MOSH-Insa-Toulouse/2019-ISS-A1-MOSH-BECHTET-MIHYUNKIM-HERAIL/notes.md

+ # Current

+ Shunt resistor: 10 Ohms
  + Normal Vshunt = 10mV
  + High Vshunt = 20mv
