MOSH-Insa-Toulouse/2019-ISS-A1-MOSH-BECHTET-MIHYUNKIM-HERAIL/CurrentMeasure/ALL0000/F0000CH1.CSV

Record Length | 2.500000e+03 | -1.250000000000 | 5.08000
Sample Interval | 1.000000e-03 | -1.249000000000 | 5.04000
Trigger Point | 1.250000000000e+03 | -1.248000000000 | 5.04000
 |  | -1.247000000000 | 5.08000
 |  | -1.246000000000 | 5.04000
 |  | -1.245000000000 | 5.04000
Source | CH1 | -1.244000000000 | 5.08000
Vertical Units | V | -1.243000000000 | 5.04000
Vertical Scale | 1.000000e+00 | -1.242000000000 | 5.08000
Vertical Offset | -6.960000e+00 | -1.241000000000 | 5.04000
Horizontal Units | s | -1.240000000000 | 5.08000
Horizontal Scale | 2.500000e-01 | -1.239000000000 | 5.04000
Pt Fmt | Y | -1.238000000000 | 5.08000
Yzero | 0.000000e+00 | -1.237000000000 | 5.04000
Probe Atten | 1.000000e+01 | -1.236000000000 | 5.08000
Model Number | TDS2001C | -1.235000000000 | 5.04000
Serial Number | C014408 | -1.234000000000 | 5.04000
Firmware Version | FV:v24.18 | -1.233000000000 | 5.08000
 |  | -01.232000000000 | 5.04000
 |  | -01.231000000000 | 5.04000
 |  | -01.230000000000 | 5.08000
 |  | -01.229000000000 | 5.04000
 |  | -01.228000000000 | 5.08000
 |  | -01.227000000000 | 5.04000
 |  | -01.226000000000 | 5.04000
 |  | -01.225000000000 | 5.04000
 |  | -01.224000000000 | 5.04000
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
