MOSH-Insa-Toulouse/2019-ISS-A1-MOSH-BECHTET-MIHYUNKIM-HERAIL/CurrentMeasure/ALL0000/F0000CH2.CSV

Record Length | 2.500000e+03 | -1.250000000000 | 4.12000
Sample Interval | 1.000000e-03 | -1.249000000000 | 4.12000
Trigger Point | 1.250000000000e+03 | -1.248000000000 | 4.12000
 |  | -1.247000000000 | 4.12000
 |  | -1.246000000000 | 4.12000
 |  | -1.245000000000 | 4.12000
Source | CH2 | -1.244000000000 | 4.16000
Vertical Units | V | -1.243000000000 | 4.12000
Vertical Scale | 1.000000e+00 | -1.242000000000 | 4.12000
Vertical Offset | -7.000000e+00 | -1.241000000000 | 4.12000
Horizontal Units | s | -1.240000000000 | 4.12000
Horizontal Scale | 2.500000e-01 | -1.239000000000 | 4.12000
Pt Fmt | Y | -1.238000000000 | 4.16000
Yzero | 0.000000e+00 | -1.237000000000 | 4.12000
Probe Atten | 1.000000e+01 | -1.236000000000 | 4.12000
Model Number | TDS2001C | -1.235000000000 | 4.08000
Serial Number | C014408 | -1.234000000000 | 4.08000
Firmware Version | FV:v24.18 | -1.233000000000 | 4.16000
 |  | -01.232000000000 | 4.16000
 |  | -01.231000000000 | 4.08000
 |  | -01.230000000000 | 4.16000
 |  | -01.229000000000 | 4.16000
 |  | -01.228000000000 | 4.12000
 |  | -01.227000000000 | 4.12000
 |  | -01.226000000000 | 4.12000
 |  | -01.225000000000 | 4.12000
 |  | -01.224000000000 | 4.12000
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
