MOSH-Insa-Toulouse/2019-ISS-A1-MOSH-BECHTET-MIHYUNKIM-HERAIL/CurrentMeasure/ALL0000/Vdiff1Kprep.csv

t | U | I
0 | 0.96 | 0.00096
0.001 | 0.92 | 0.00092
0.002 | 0.92 | 0.00092
0.003 | 0.96 | 0.00096
0.004 | 0.92 | 0.00092
0.005 | 0.92 | 0.00092
0.006 | 0.92 | 0.00092
0.007 | 0.92 | 0.00092
0.008 | 0.96 | 0.00096
0.009 | 0.92 | 0.00092
0.01 | 0.96 | 0.00096
0.011 | 0.92 | 0.00092
0.012 | 0.92 | 0.00092
0.013 | 0.92 | 0.00092
0.014 | 0.96 | 0.00096
0.015 | 0.96 | 0.00096
0.016 | 0.96 | 0.00096
0.017 | 0.92 | 0.00092
0.018 | 0.88 | 0.00088
0.019 | 0.96 | 0.00096
0.02 | 0.92 | 0.00092
0.021 | 0.88 | 0.00088
0.022 | 0.96 | 0.00096
0.023 | 0.92 | 0.00092
0.024 | 0.92 | 0.00092
0.025 | 0.92 | 0.00092
0.026 | 0.92 | 0.00092
0.027 | 0.96 | 0.00096
0.028 | 0.92 | 0.00092
0.029 | 0.92 | 0.00092
0.03 | 0.92 | 0.00092
0.031 | 0.96 | 0.00096
0.032 | 0.92 | 0.00092
0.033 | 0.96 | 0.00096
0.034 | 0.92 | 0.00092
0.035 | 0.96 | 0.00096
0.036 | 0.92 | 0.00092
0.037 | 0.92 | 0.00092
0.038 | 0.92 | 0.00092
0.039 | 0.92 | 0.00092
0.04 | 0.92 | 0.00092
0.041 | 0.96 | 0.00096
0.042 | 0.96 | 0.00096
0.043 | 0.92 | 0.00092
0.044 | 0.92 | 0.00092
0.045 | 0.96 | 0.00096
0.046 | 0.96 | 0.00096
0.047 | 0.92 | 0.00092
0.048 | 0.92 | 0.00092
0.049 | 0.96 | 0.00096
0.05 | 0.88 | 0.00088
0.051 | 0.92 | 0.00092
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
