MOSH-Insa-Toulouse/2019-ISS-A1-MOSH-BECHTET-MIHYUNKIM-HERAIL/CurrentMeasure/ALL0000/F0000TEK.BMP

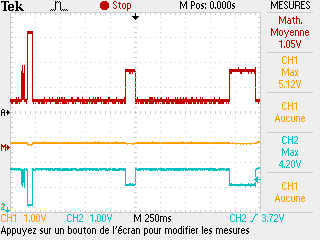
CurrentMeasure/ALL0000/F0000TEK.BMP
