MOSH-Insa-Toulouse/2019-ISS-A1-MOSH-BECHTET-MIHYUNKIM-HERAIL/GasSensor_Kicad/Communicating_GasSensor.kicad_pcb

## KiCad design GasSensor_Kicad/Communicating_GasSensor.kicad_pcb (2020-01-22)

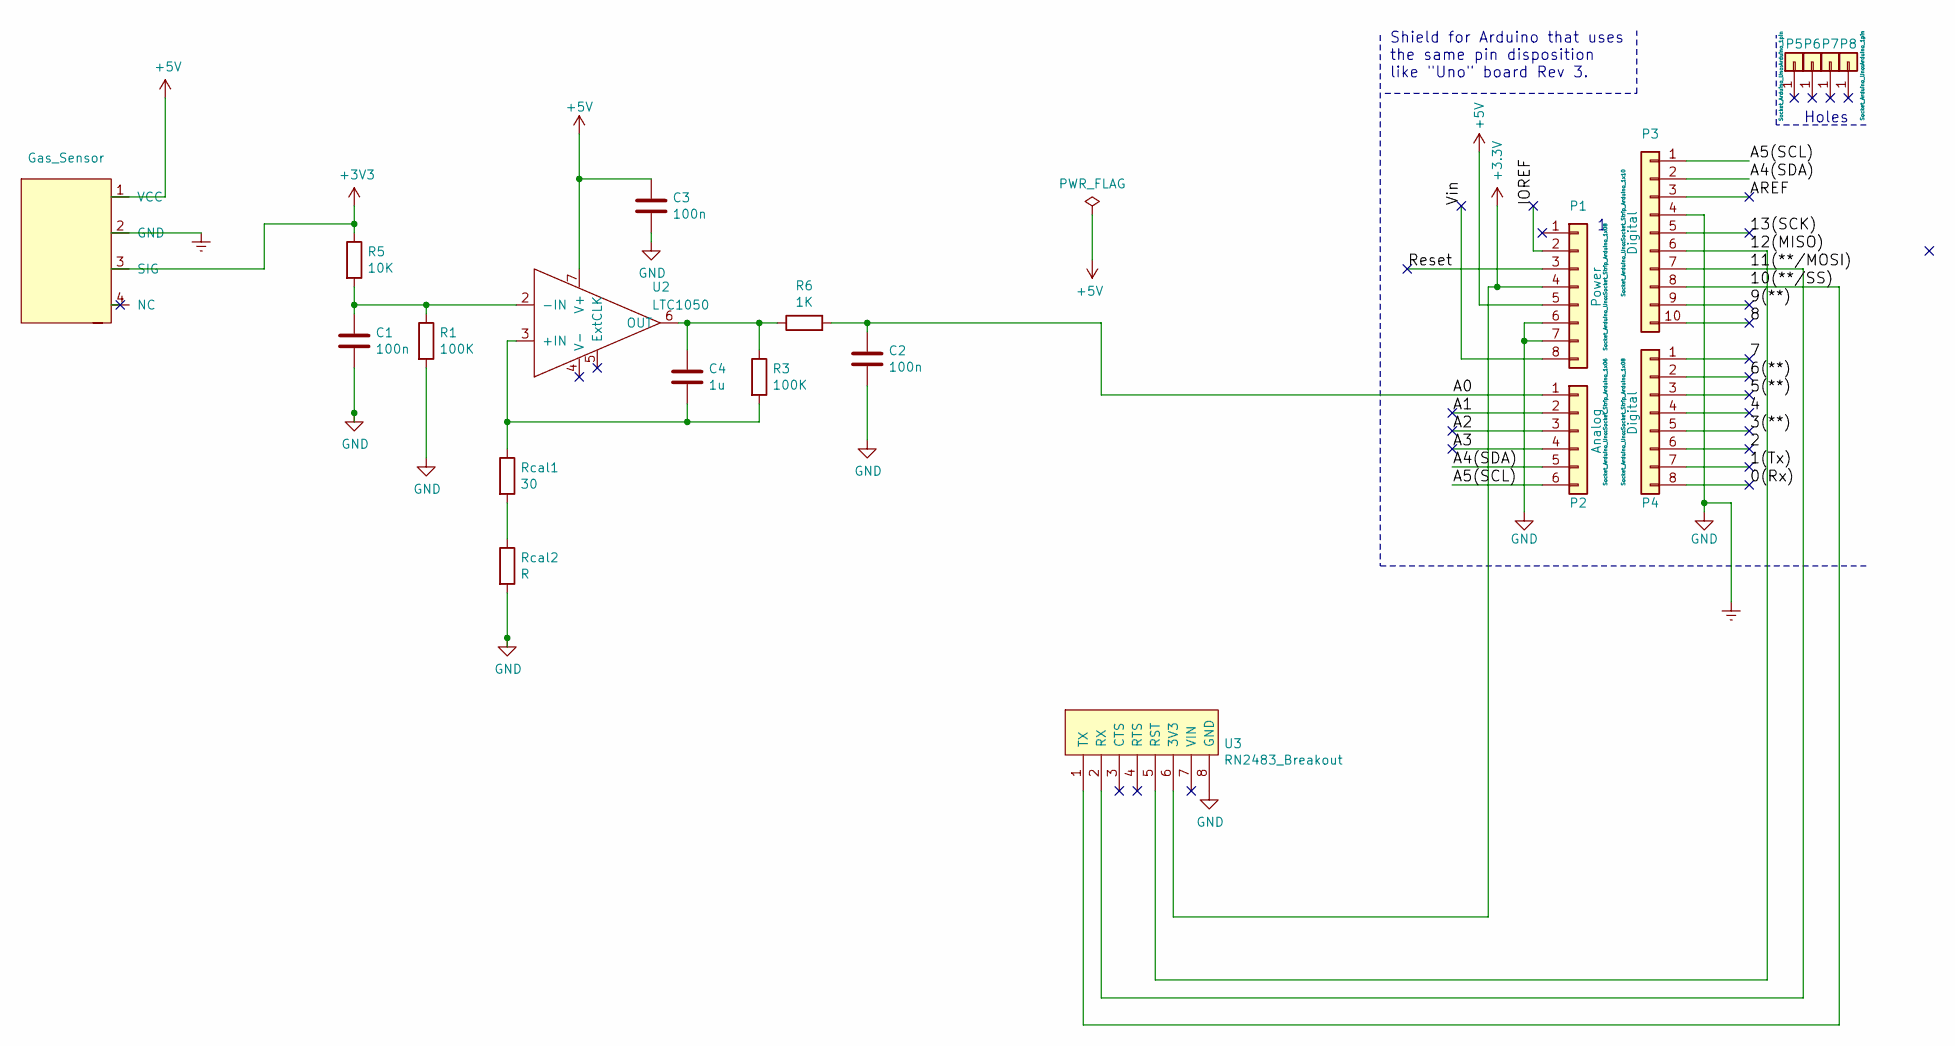
[picture p7: schematic Communicating_GasSensor.sch]

Parts:
C1, C2, C3: 100n; CP_Elec_4x3
C4: 1u; CP_Elec_4x3
P1: Power; Socket_Strip_Arduino_1x08
P2: Analog; Socket_Strip_Arduino_1x06
P3: Digital; Socket_Strip_Arduino_1x10
P4: Digital; Socket_Strip_Arduino_1x08
P5, P6, P7, P8: CONN_01X01; Arduino_1pin
R1, R3: 100K; R_Axial_DIN0204_L3.6mm_D1.6mm_P1.90mm_Vertical
R5: 10K; R_Axial_DIN0204_L3.6mm_D1.6mm_P1.90mm_Vertical
R6: 1K; R_Axial_DIN0204_L3.6mm_D1.6mm_P1.90mm_Vertical
Rcal1: 30; R_Axial_DIN0204_L3.6mm_D1.6mm_P1.90mm_Vertical
Rcal2: R; R_Axial_DIN0204_L3.6mm_D1.6mm_P1.90mm_Vertical
U1: Gas_Sensor; TO-5-4
U2: LTC1050; DIP-8_W7.62mm_LongPads
U3: RN2483_Breakout

Connections:
+5V: C3.1, P1.5, U1.1 (VCC), U2.7 (V+)
/0(Rx): P4.8
/1(Tx): P4.7
/2: P4.6
/3(**): P4.5
/4: P4.4
/5(**): P4.3
/6(**): P4.2
/7: P4.1
/8: P3.10
/9(**): P3.9
/10(**/SS): P3.8, U3.1 (TX)
/11(**/MOSI): P3.7, U3.2 (RX)
/12(MISO): P3.6, U3.5 (RST)
/13(SCK): P3.5
/A0: C2.1, P2.1, R6.2
/A1: P2.2
/A2: P2.3
/A3: P2.4
/A4(SDA): P2.5, P3.2
/A5(SCL): P2.6, P3.1
/AREF: P3.3
/IOREF: P1.2
/Reset: P1.3
/Vin: P1.8
Earth: C1.2, C2.2, C3.2, P1.6, P1.7, P3.4, R1.2, Rcal2.2, U1.2 (GND), U3.8 (GND)
unnamed: C1.1, R1.1, R5.2, U2.2 (-IN)
unnamed: C4.1, R3.1, R6.1, U2.6 (OUT)
unnamed: C4.2, R3.2, Rcal1.1, U2.3 (+IN)
unnamed: Rcal1.2, Rcal2.1

Notes on the sheet:
Holes
Shield for Arduino that uses the same pin disposition like "Uno" board Rev 3.

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
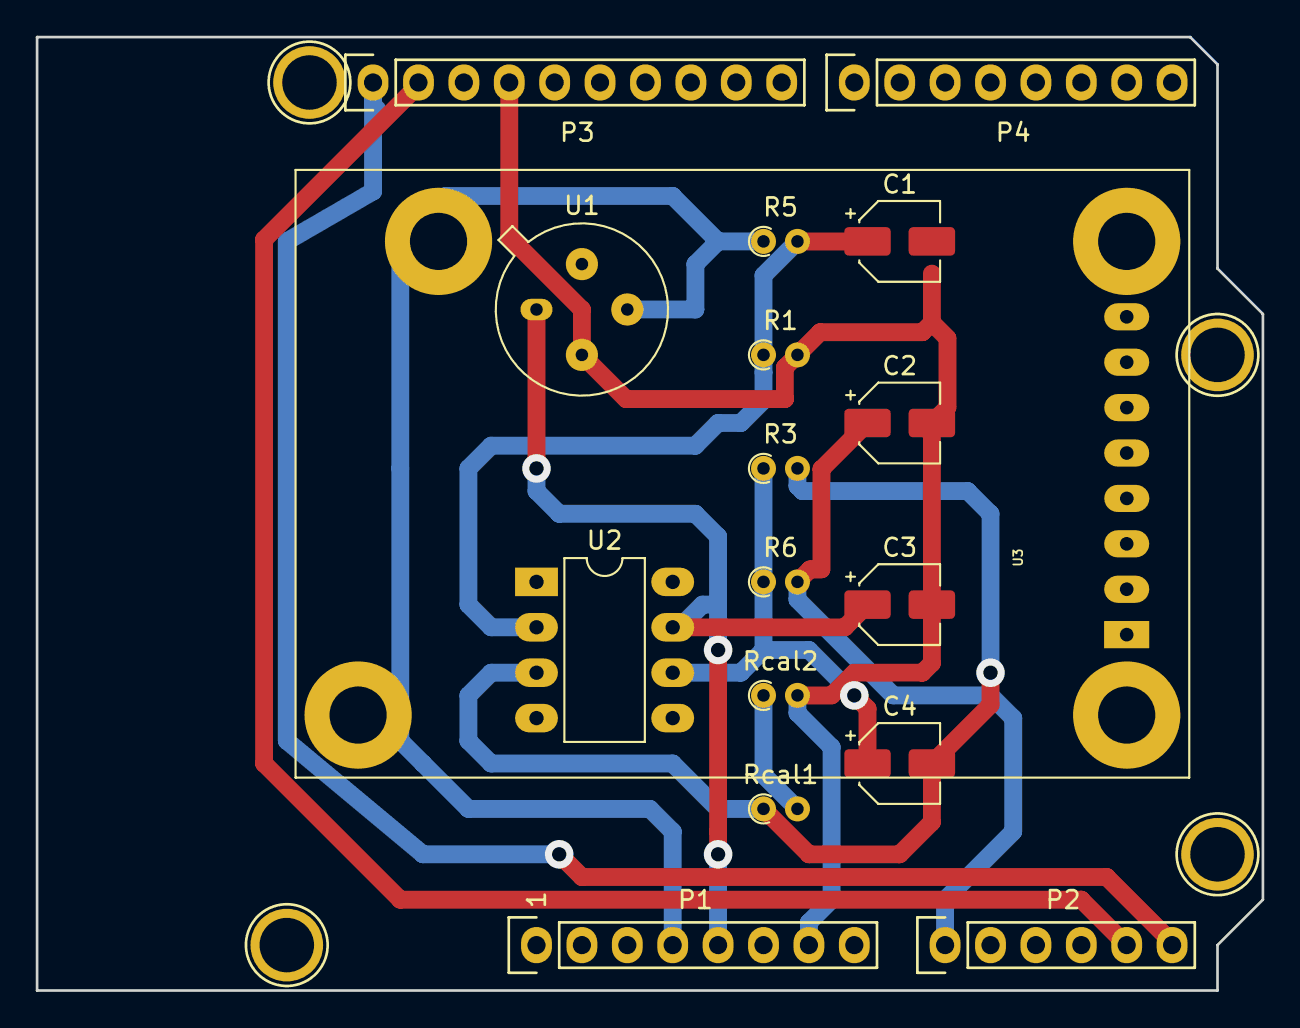
[picture p8: board Communicating_GasSensor.kicad_pcb from above]

Board: 2 copper layers, 68.6 x 53.3 mm, 21 parts (0 on the bottom side), 13 nets.
