MOSH-Insa-Toulouse/2019-ISS-A1-MOSH-BECHTET-MIHYUNKIM-HERAIL/ArduinoUnoNano-downlink-custom/ArduinoUnoNano-downlink-custom.ino

/*
 * Author: Dennis Ruigrok and JP Meijers
 * Date: 2017-01-16
 *
 * This program is meant to be used with an Arduino UNO or NANO, conencted to an RNxx3 radio module.
 * It will most likely also work on other compatible Arduino or Arduino compatible boards,
 * like The Things Uno, but might need some slight modifications.
 *
 * Transmit a one byte packet via TTN, using confirmed messages,
 * waiting for an acknowledgement or a downlink message.
 *
 * CHECK THE RULES BEFORE USING THIS PROGRAM!
 *
 * CHANGE ADDRESS!
 * Change the device address, network (session) key, and app (session) key to the values
 * that are registered via the TTN dashboard.
 * The appropriate line is "myLora.initABP(XXX);" or "myLora.initOTAA(XXX);"
 * When using ABP, it is advised to enable "relax frame count".
 *
 * Connect the RN2xx3 as follows:
 * RN2xx3 -- Arduino
 * Uart TX -- 10
 * Uart RX -- 11
 * Reset -- 12
 * Vcc -- 3.3V
 * Gnd -- Gnd
 *
 * If you use an Arduino with a free hardware serial port, you can replace
 * the line "rn2xx3 myLora(mySerial);"
 * with     "rn2xx3 myLora(SerialX);"
 * where the parameter is the serial port the RN2xx3 is connected to.
 * Remember that the serial port should be initialised before calling initTTN().
 * For best performance the serial port should be set to 57600 baud, which is impossible with a software serial port.
 * If you use 57600 baud, you can remove the line "myLora.autobaud();".
 *
 */
#include <rn2xx3.h>
#include <SoftwareSerial.h>
#include <avr/sleep.h>

SoftwareSerial mySerial(10, 11); // TX, RX

//create an instance of the rn2xx3 library,
//giving the software serial as port to use
rn2xx3 myLora(mySerial);

/******************
 * ISR Var declaration
 * ****************/

//Boolean value to hold the fact that
//the analog comp was triggered
volatile bool triggered = false;
volatile float gasSensorValue;

//This function handles the interrupt of the analog comparator
//Should be as short as possible
void gasSensorISR()
{
    if(digitalRead(2) == HIGH)  
    { 
        triggered = true;
        gasSensorValue = getGasSensorVoltage();
    }
    //TODO: save value on trigger ?
}

// the setup routine runs once when you press reset:
void setup()
{
    //output LED pin
    pinMode(13, OUTPUT);

    // Open serial communications and wait for port to open:
    Serial.begin(57600);  //serial port to computer
    mySerial.begin(9600); //serial port to radio
    Serial.println("Startup");

    initialize_radio();

    //transmit a startup message
    myLora.tx("TTN Mapper on TTN Enschede node");

    //Setup the analog comparator
    setupAcomp();

    delay(1000);
}

void initialize_radio()
{
    //reset rn2483
    pinMode(12, OUTPUT);
    digitalWrite(12, LOW);
    delay(500);
    digitalWrite(12, HIGH);

    delay(100); //wait for the RN2xx3's startup message
    mySerial.flush();

    //Autobaud the rn2483 module to 9600. The default would otherwise be 57600.
    myLora.autobaud();

    //check communication with radio
    String hweui = myLora.hweui();
    while (hweui.length() != 16)
    {
        Serial.println("Communication with RN2xx3 unsuccesful. Power cycle the board.");
        Serial.println(hweui);
        delay(10000);
        hweui = myLora.hweui();

    }

    //print out the HWEUI so that we can register it via ttnctl
    Serial.println("When using OTAA, register this DevEUI: ");
    Serial.println(myLora.hweui());
    Serial.println("RN2xx3 firmware version:");
    Serial.println(myLora.sysver());

    //configure your keys and join the network
    Serial.println("Trying to join TTN");
    bool join_result = false;

    //ABP: initABP(String addr, String AppSKey, String NwkSKey);
    //join_result = myLora.initABP("02017201", "8D7FFEF938589D95AAD928C2E2E7E48F", "AE17E567AECC8787F749A62F5541D522");

    //OTAA: initOTAA(String AppEUI, String AppKey);
    const char *appEui = "70B3D57ED0025AF4";
    const char *appKey = "97D1E4ECE8E172261187351B747CBE4A";

    join_result = myLora.initOTAA(appEui, appKey);

    while (!join_result)
    {
        Serial.println("Unable to join. Are your keys correct, and do you have TTN coverage?");
        // delay(60000); //delay a minute before retry
        delay(10000); //delay 10 second before retrying
        join_result = myLora.init();
    }
    Serial.println("Successfully joined TTN");

    //Set Lora params, seems to have no effect
     Serial.println(myLora.sendRawCommand("radio set sf sf12"));
}

/****************************
 * Variables for the main loop 
 ****************************/
String sensor_value;

/****************************
 * Main Loop
 ****************************/
// the loop routine runs over and over again forever:
void loop()
{

    Serial.println("Loop beg");
    // Send data if sensor is triggered
    if (triggered)
    {
        triggered = false;
        Serial.println("Interrupt worked !");

        //Get gas sensor data
        // TODO Modify the code to get data when the interrupt is fired
        sensor_value = String(gasSensorValue);
        Serial.println("Sensor value: " + sensor_value);
        sendData(sensor_value);
    }
    Serial.println("Will go to sleep...");
    // delay(1000);

    // TODO test
    // Puts the board to sleep, will return on interrupt
    putBoardSleep();
}

float getGasSensorVoltage()
{
    float sensor_volt;
    float sensorValue;

    sensorValue = analogRead(A0);
    sensor_volt = sensorValue / 1024 * 5.0;
    return sensor_volt;
}

//Used to setup the register for the analog comparator
//Pins used:
//  + AIN0: Ref voltage = pin D6
//  + AIN1: Tested voltage = pin D7
void setupAcomp()
{
    pinMode(2, INPUT);
    attachInterrupt(digitalPinToInterrupt(2), gasSensorISR, RISING);

    /**
     * Use this to use the  analog comparator instead of an external Schmidt trigger
     * This will not be able to wake the MCU from power down mode
     */
    // ACSR =
    //     (0 << ACD) |                // Analog Comparator: Enabled
    //     (0 << ACBG) |               // Analog Comparator Bandgap Select: AIN0 is applied to the positive input
    //     (0 << ACO) |                // Analog Comparator Output: Off
    //     (1 << ACI) |                // Analog Comparator Interrupt Flag: Clear Pending Interrupt
    //     (1 << ACIE) |               // Analog Comparator Interrupt: Enabled
    //     (0 << ACIC) |               // Analog Comparator Input Capture: Disabled
    //     (1 << ACIS1) | (1 << ACIS0); // Analog Comparator Interrupt Mode: Comparator Interrupt on Rising Output Edge
}

//Sends data with LoRa
//Handles the response from the chip
void sendData(String data)
{
    switch (myLora.txCnf(data)) //blocking function
    {
    case TX_FAIL:
    {
        Serial.println("TX unsuccessful or not acknowledged");
        break;
    }
    case TX_SUCCESS:
    {
        Serial.println("TX successful and acknowledged");
        Serial.print(myLora.getSNR());
        Serial.print("\n");
        break;
    }
    case TX_WITH_RX:
    {
        String received = myLora.getRx();
        received = myLora.base16decode(received);
        Serial.print("Received downlink: " + received);
        Serial.print(myLora.getSNR());
        break;
    }
    default:
    {
        Serial.println("Unknown response from TX function");
    }
    }
}

//Puts the arduino to sleep
//Returns when MCU gets awaken by interrupt
void putBoardSleep()
{
    sleep_enable();
    set_sleep_mode(SLEEP_MODE_PWR_DOWN);
    // TODO check if other stuff are to be stopped
    sleep_cpu();
}
