MOSH-Insa-Toulouse/2019-ISS-A1-MOSH-BECHTET-MIHYUNKIM-HERAIL/RN2483-Arduino-Library-master/examples/SodaqOne-TTN-Mapper-ascii/Sodaq_UBlox_GPS.h

/*
* Copyright (c) 2016 SODAQ. All rights reserved.
*
* This file is part of Sodaq_UBlox_GPS.
*
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
* You should have received a copy of the GNU Lesser General Public License
* along with Sodaq_UBlox_GPS.  If not, see <http://www.gnu.org/licenses/>.
*/

#ifndef _SODAQ_UBLOX_GPS_H
#define _SODAQ_UBLOX_GPS_H

#include <WString.h>
#include <stdint.h>

class Sodaq_UBlox_GPS
{
public:
    Sodaq_UBlox_GPS();

    void init(int8_t enable_pin);
    bool scan(bool leave_on=false, uint32_t timeout=20000);
    String getDateTimeString();
    double getLat() { return _lat; }
    double getLon() { return _lon; }
    double getAlt() { return _alt; }
    double getHDOP() { return _hdop; }
    uint8_t getNumberOfSatellites() { return _numSatellites; }
    uint16_t getYear() { return (uint16_t)_yy + 2000; }         // 2016..
    uint8_t getMonth() { return _MM; }         // 1..
    uint8_t getDay() { return _dd; }           // 1..
    uint8_t getHour() { return _hh; }          // 0..
    uint8_t getMinute() { return _mm; }        // 0..
    uint8_t getSecond() { return _ss; }        // 0..

    // How many extra lines must scan see before it stops? This is merely for debugging
    void setMinNumOfLines(size_t num) { _minNumOfLines = num; }

    // The minimum number of satellites to satisfy scan
    void setMinNumSatellites(size_t num) { _minNumSatellites = num; }

    // Sets the optional "Diagnostics and Debug" stream.
    void setDiag(Stream &stream) { _diagStream = &stream; }
    void setDiag(Stream *stream) { _diagStream = stream; }

private:
    void on();
    void off();

    // Read one byte
    uint8_t read();
    bool readLine(uint32_t timeout = 10000);
    bool parseLine(const char * line);
    bool parseGPGGA(const String & line);
    bool parseGPGSA(const String & line);
    bool parseGPRMC(const String & line);
    bool parseGPGSV(const String & line);
    bool parseGPGLL(const String & line);
    bool parseGPVTG(const String & line);
    bool parseGPTXT(const String & line);
    bool computeCrc(const char * line, bool do_logging=false);
    uint8_t getHex2(const char * s, size_t index);
    String num2String(int num, size_t width);
    String getField(const String & data, int index);
    double convertDegMinToDecDeg(const String & data);

    void setDateTime(const String & date, const String & time);

    void beginTransmission();
    void endTransmission();

    void resetValues();

    int8_t      _enablePin;

    // The (optional) stream to show debug information.
    Stream *    _diagStream;

    uint8_t     _addr;

    size_t      _minNumOfLines;

    // Minimum number of satellites to satisfy scan(). Zero means any number is OK.
    size_t      _minNumSatellites;

    bool        _seenLatLon;
    bool        _seenAlt;
    uint8_t     _numSatellites;
    double      _lat;
    double      _lon;
    double      _alt;
    double      _hdop;

    bool        _seenTime;
    uint8_t     _yy;
    uint8_t     _MM;
    uint8_t     _dd;
    uint8_t     _hh;
    uint8_t     _mm;
    uint8_t     _ss;

    bool        _trans_active;

    static const char _fieldSep;
    char *      _inputBuffer;
    size_t      _inputBufferSize;
};

extern Sodaq_UBlox_GPS sodaq_gps;

#endif // _SODAQ_UBLOX_GPS_H
