MOSH-Insa-Toulouse/2019-ISS-A1-MOSH-BECHTET-MIHYUNKIM-HERAIL/(commit log)

2019-11-18 with the test for gas sensor
2019-11-18 basic interrupt
2019-11-18 Some fixes, still to be tested
    [ArduinoUnoNano-downlink-custom.ino]
2019-11-19 Interrupt + sleep working basic
2019-11-20 node red flow
2019-11-25 Measures with first
    [F0000CH1.CSV, F0000CH2.CSV, F0000MTH.CSV, F0000RFA.CSV, Vdiff1K.CSV, Vdiff1Kprep.csv]
