MOSH-Insa-Toulouse/2019-ISS-A1-MOSH-BECHTET-MIHYUNKIM-HERAIL/(notices)

Notices in the files:
RN2483-Arduino-Library-master/examples/SodaqOne-TTN-Mapper-binary/Sodaq_UBlox_GPS.cpp:
Sodaq_UBlox_GPS is free software: you can redistribute it and/or modify
it under the terms of the GNU Lesser General Public License as published
